Sid93/hemosure-casing/renders/HemoSure_Exploded_20261006T072656Z.png

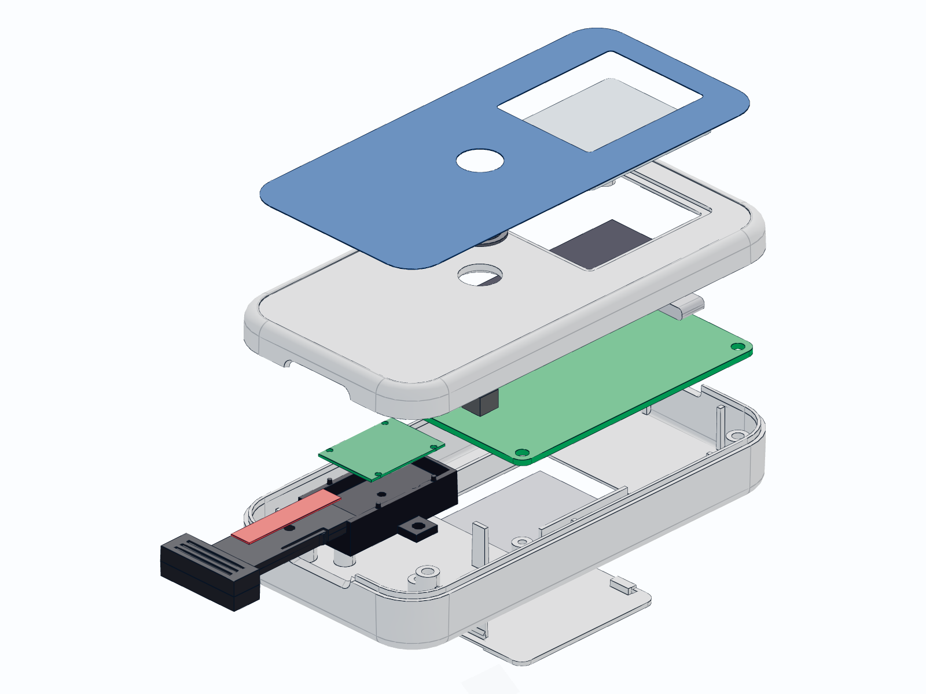
renders/HemoSure_Exploded_20261006T072656Z.png
