Sid93/hemosure-casing/renders/HemoSure_Front_Housing_20260929T104117Z.png

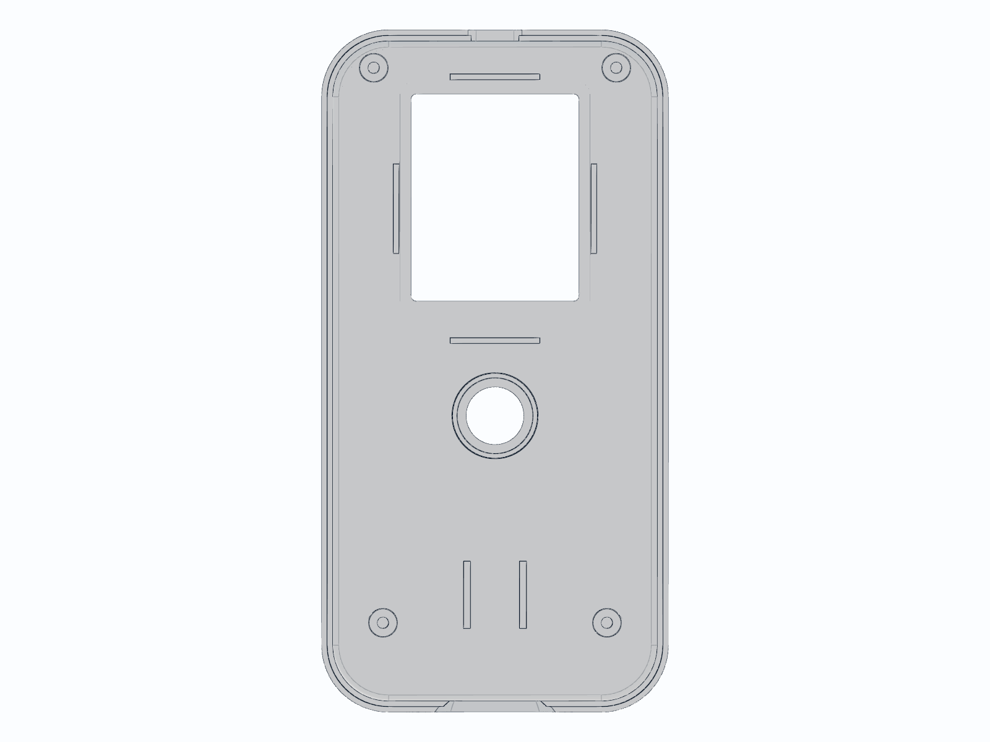
renders/HemoSure_Front_Housing_20260929T104117Z.png
