Sid93/hemosure-casing/renders/HemoSure_Optical_Block_20260929T104113Z.png

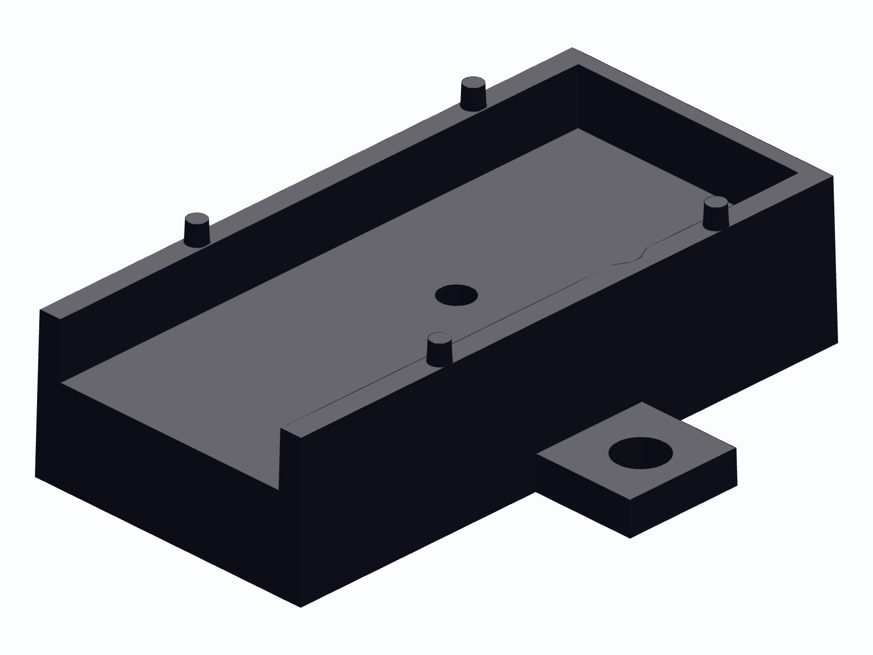
renders/HemoSure_Optical_Block_20260929T104113Z.png
