Sid93/hemosure-casing/renders/HemoSure_Rear_Housing_20260929T104120Z.png

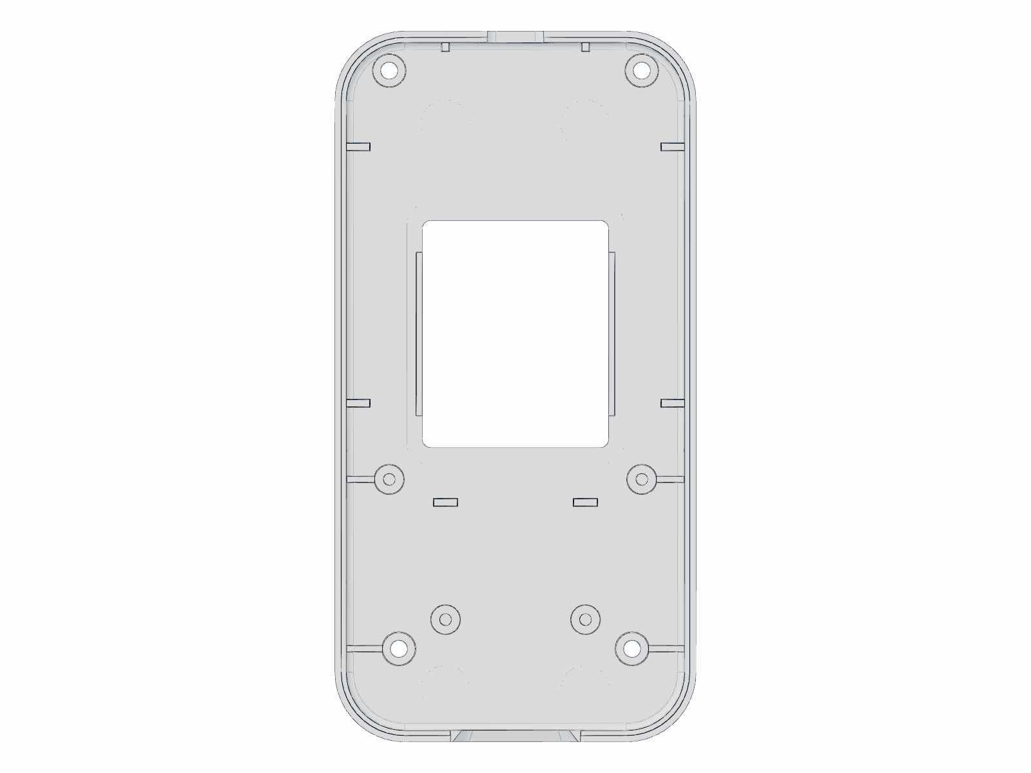
renders/HemoSure_Rear_Housing_20260929T104120Z.png
