Sid93/hemosure-casing/renders/HemoSure_Rear_Housing_CAVITY_20260929T104127Z.png

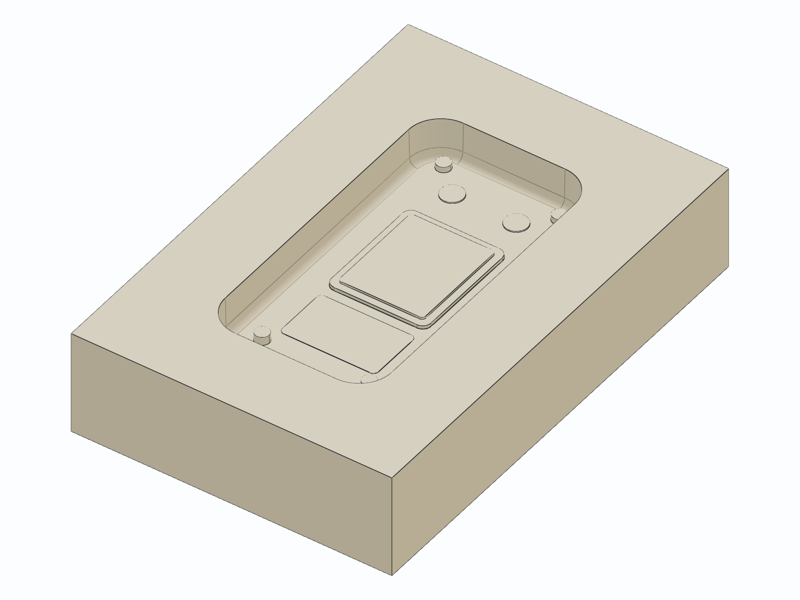
renders/HemoSure_Rear_Housing_CAVITY_20260929T104127Z.png
