Sid93/hemosure-casing/renders/HemoSure_Rear_Housing_CORE_20260929T104123Z.png

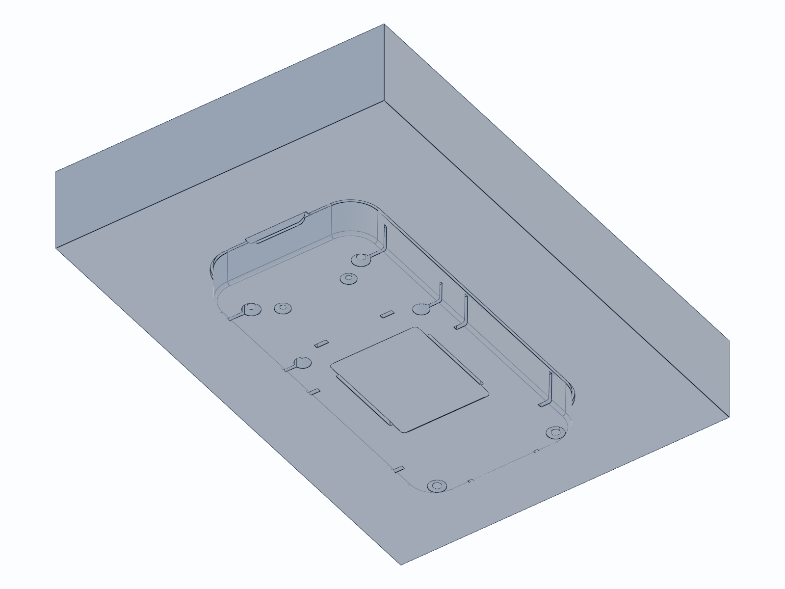
renders/HemoSure_Rear_Housing_CORE_20260929T104123Z.png
