Sid93/hemosure-casing/renders/HemoSure_Strip_Tray_20261006T072645Z.png

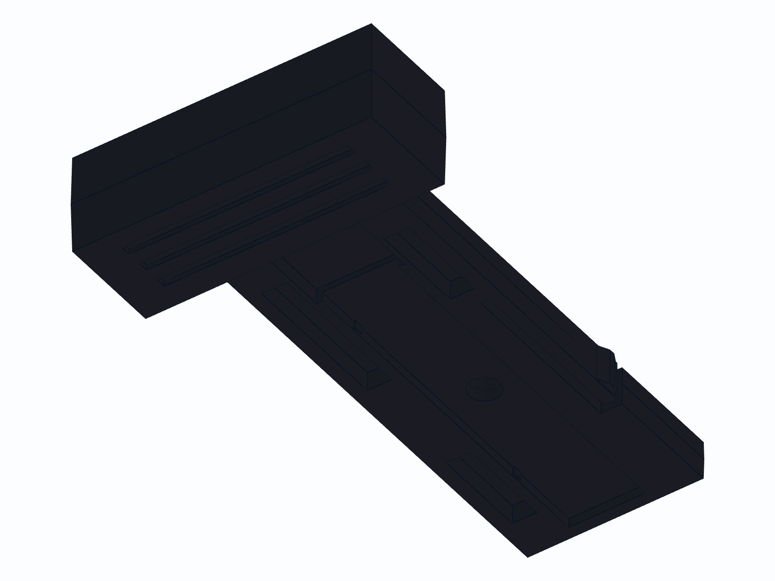
renders/HemoSure_Strip_Tray_20261006T072645Z.png
