Sid93/hemosure-casing/renders/HemoSure_Tray_Open_20261006T072652Z.png

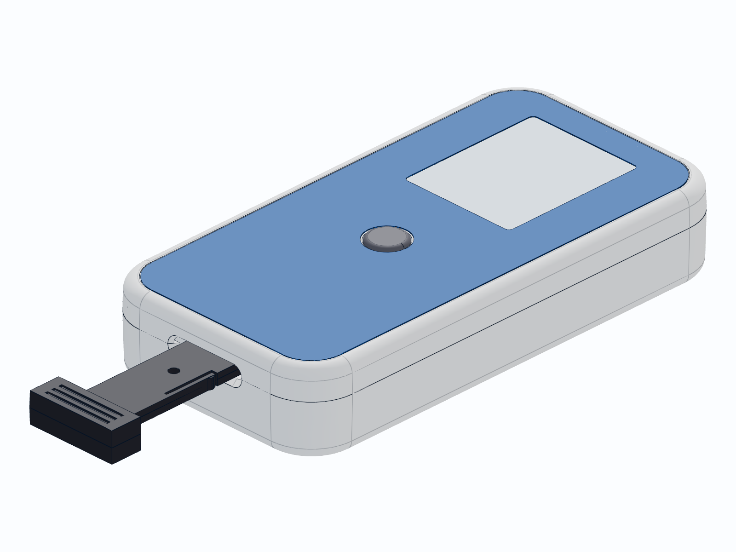
renders/HemoSure_Tray_Open_20261006T072652Z.png
