Sid93/hemosure-casing/cad/HemoSure_Assembly.step

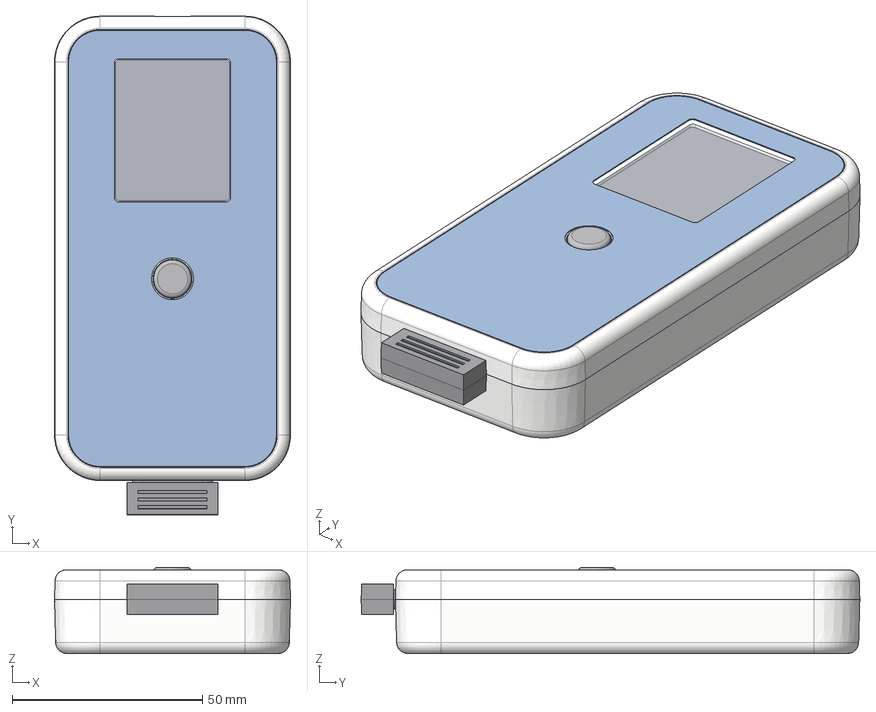
[picture p18: CAD file, 2026-10-06]
cad/HemoSure_Assembly.step
62.0 x 131.0 x 22.6 mm
rear_housing
front_housing
battery_door
button_cap
optical_block_BLACK_ABS
strip_tray_BLACK_ABS
display_lens_PMMA
overlay_PC_printed
REF_pcb_76.75x49.94
REF_tft_1.8in_ST7735
REF_usb_c_receptacle
REF_tact_6x6x5
REF_lipo_503035
REF_hb_strip_6x30x0.5
REF_led_board
