Sid93/hemosure-casing/cad/HemoSure_Exploded.step

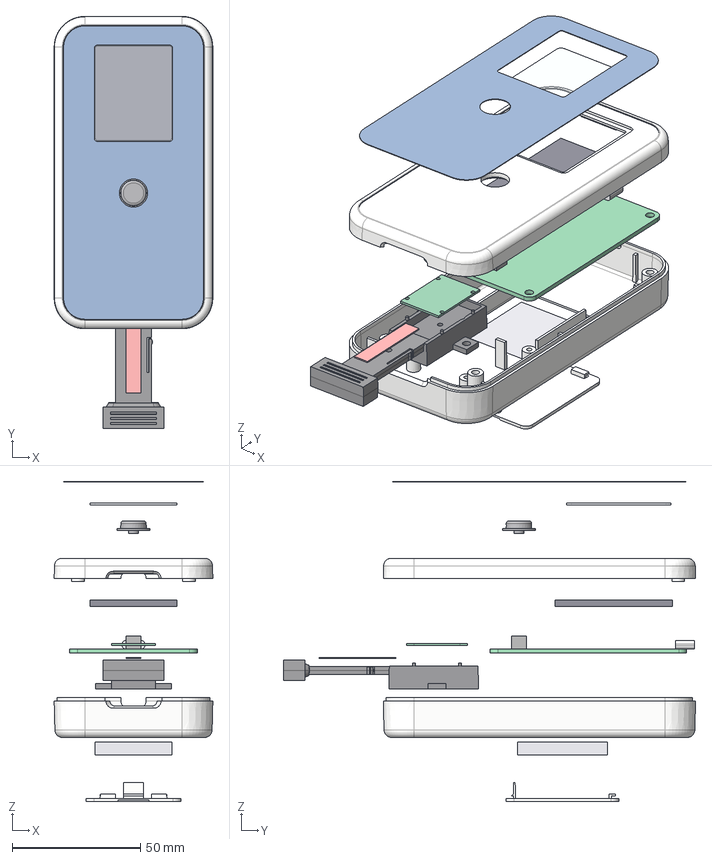
[picture p19: CAD file, 2026-10-06]
cad/HemoSure_Exploded.step
62.0 x 161.0 x 125.0 mm
battery_door
rear_housing
REF_lipo_503035
optical_block_BLACK_ABS
strip_tray_BLACK_ABS
REF_hb_strip_6x30x0.5
REF_led_board
REF_pcb_76.75x49.94
REF_usb_c_receptacle
REF_tact_6x6x5
REF_tft_1.8in_ST7735
front_housing
button_cap
display_lens_PMMA
overlay_PC_printed
