Sid93/hemosure-casing/mold/HemoSure_Strip_Tray_CAVITY.step

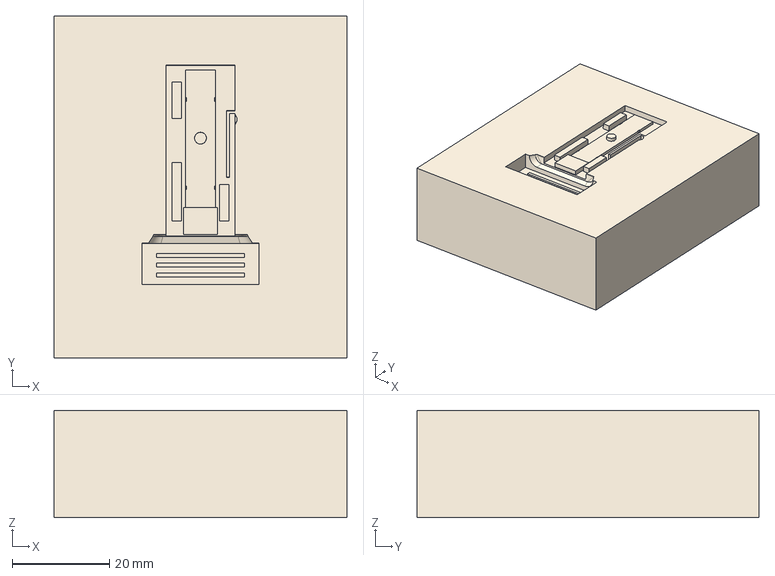
[picture p20: CAD file, 2026-10-06]
mold/HemoSure_Strip_Tray_CAVITY.step
60.3 x 70.3 x 22.1 mm
