Sid93/hemosure-casing/cad/HemoSure_Strip_Tray.step

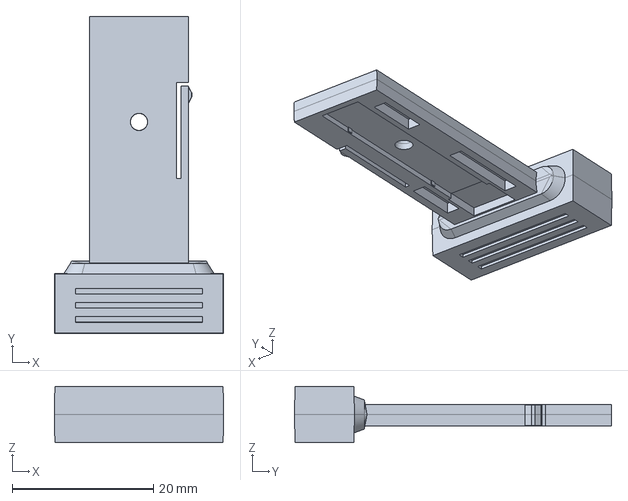
[picture p21: CAD file, 2026-10-06]
cad/HemoSure_Strip_Tray.step
24.0 x 45.0 x 8.00 mm
