Sid93/hemosure-casing/cad/HemoSure_Tray_Open.step

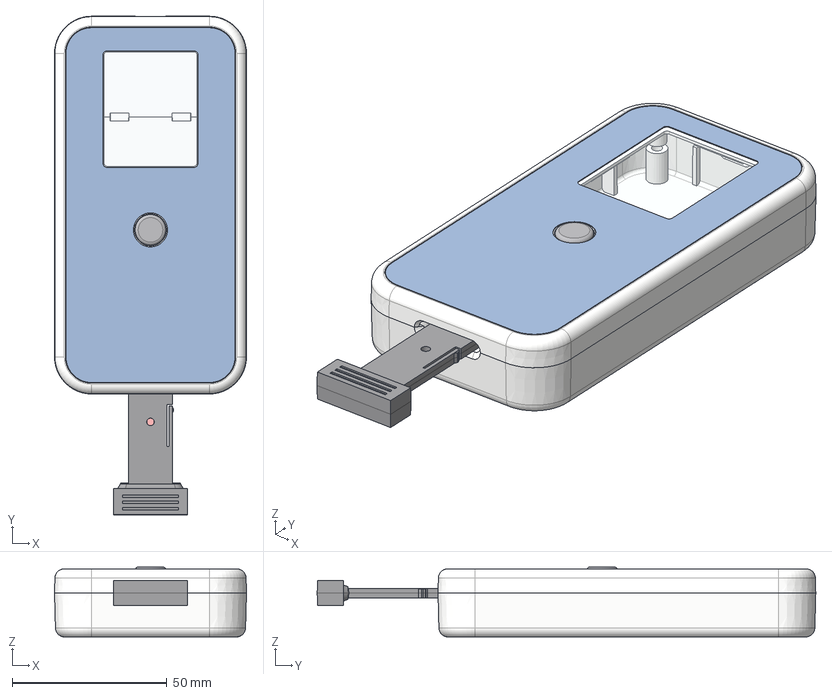
[picture p22: CAD file, 2026-10-06]
cad/HemoSure_Tray_Open.step
62.0 x 161.0 x 22.6 mm
rear_housing
front_housing
button_cap
display_lens_PMMA
overlay_PC_printed
battery_door
strip_tray_BLACK_ABS
REF_hb_strip_6x30x0.5
