Sid93/hemosure-casing/mold/HemoSure_Optical_Block_CORE.step

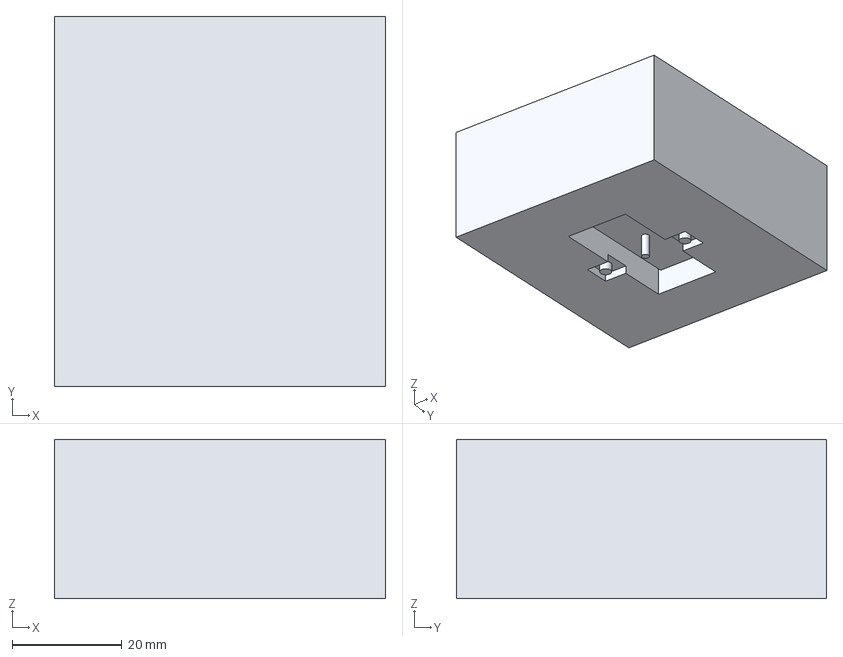
[picture p23: CAD file, 2026-09-29]
mold/HemoSure_Optical_Block_CORE.step
60.3 x 67.3 x 29.0 mm
