Sid93/hemosure-casing/mold/HemoSure_Button_Cap_CAVITY.step

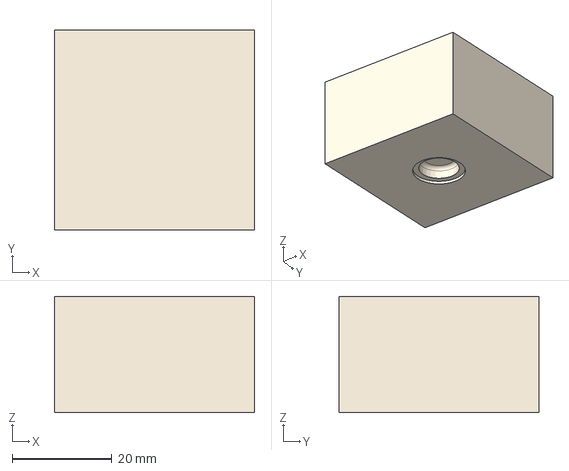
[picture p24: CAD file, 2026-09-29]
mold/HemoSure_Button_Cap_CAVITY.step
40.2 x 40.2 x 23.3 mm
