Sid93/hemosure-casing/stl/HemoSure_Button_Cap_CORE.stl

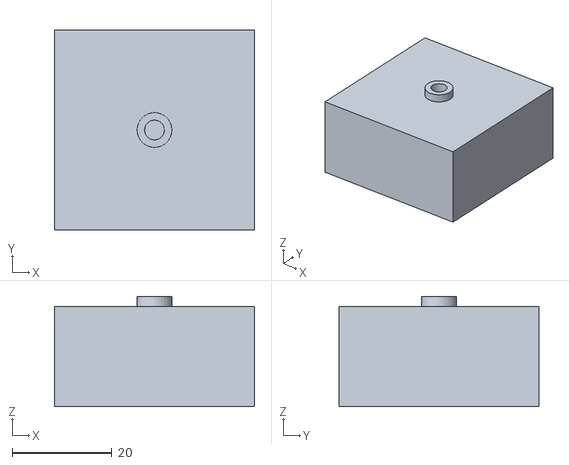
[picture p25: CAD file, 2026-09-28]
stl/HemoSure_Button_Cap_CORE.stl
40.2 x 40.2 x 22.1
