Sid93/hemosure-casing/cad/HemoSure_Battery_Door.step

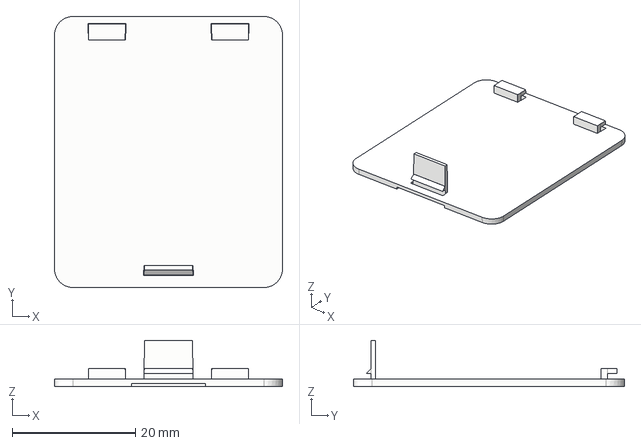
[picture p26: CAD file, 2026-09-29]
cad/HemoSure_Battery_Door.step
37.0 x 44.0 x 7.50 mm
