Sid93/hemosure-casing/mold/HemoSure_Rear_Housing_CAVITY.step

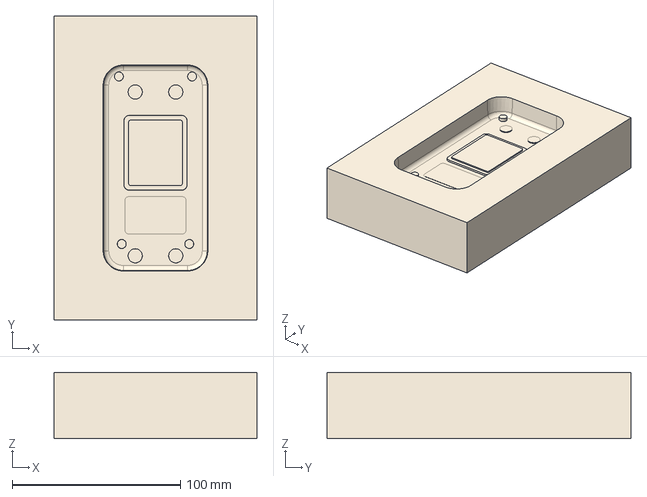
[picture p27: CAD file, 2026-09-29]
mold/HemoSure_Rear_Housing_CAVITY.step
120.6 x 180.9 x 39.4 mm
