Sid93/hemosure-casing/stl/HemoSure_Battery_Door_CAVITY.stl

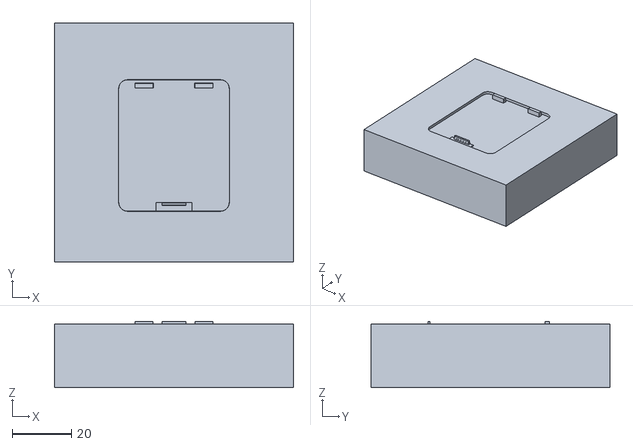
[picture p28: CAD file, 2026-09-28]
stl/HemoSure_Battery_Door_CAVITY.stl
80.4 x 80.4 x 22.2
