Sid93/hemosure-casing/cad/HemoSure_Display_Lens.step

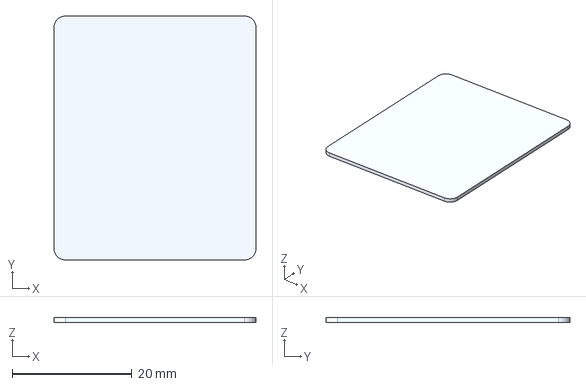
[picture p29: CAD file, 2026-09-29]
cad/HemoSure_Display_Lens.step
33.8 x 40.8 x 0.8 mm
