Sid93/hemosure-casing/cad/HemoSure_Button_Cap.step

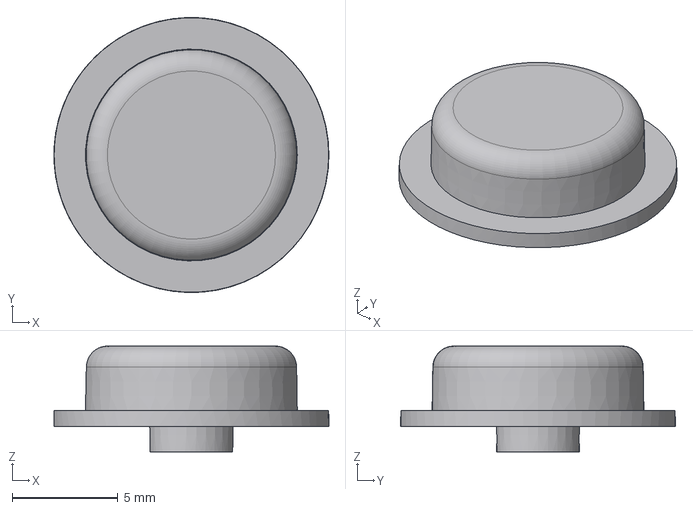
[picture p30: CAD file, 2026-09-29]
cad/HemoSure_Button_Cap.step
13.0 x 13.0 x 5.00 mm
