Sid93/hemosure-casing/stl/HemoSure_Front_Housing_CAVITY.stl

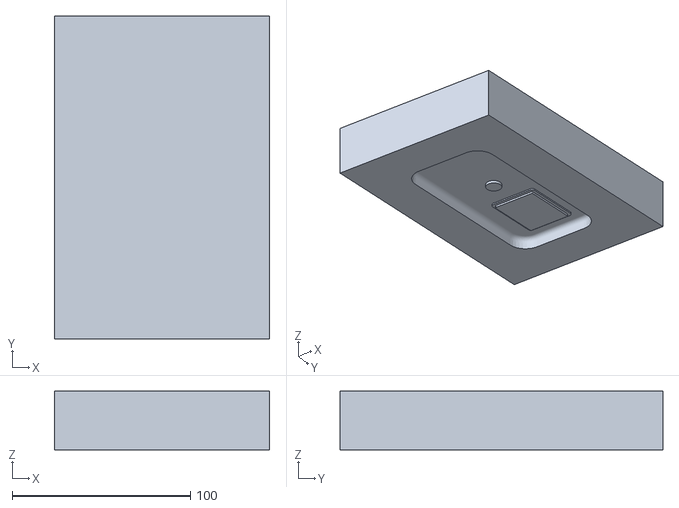
[picture p31: CAD file, 2026-09-28]
stl/HemoSure_Front_Housing_CAVITY.stl
120.6 x 180.9 x 33.0
