Sid93/hemosure-casing/cad/HemoSure_Rear_Housing.step

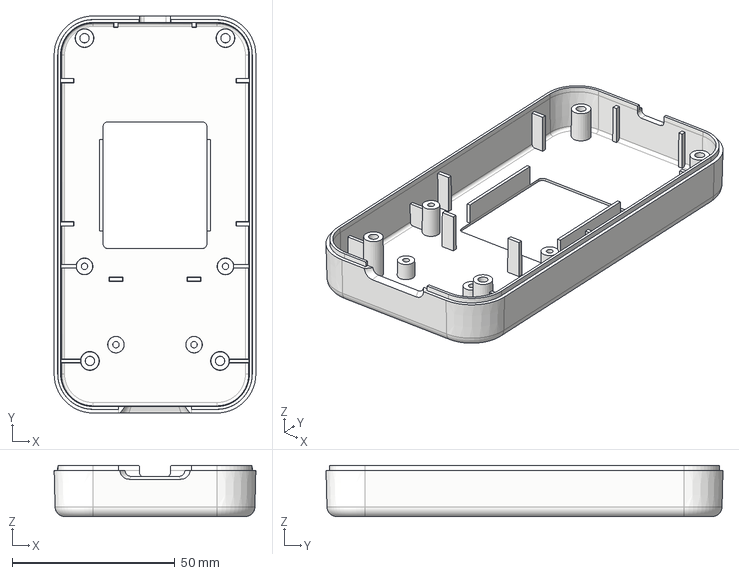
[picture p32: CAD file, 2026-09-29]
cad/HemoSure_Rear_Housing.step
62.0 x 122.0 x 15.7 mm
