Sid93/hemosure-casing/mold/HemoSure_Front_Housing_CORE.step

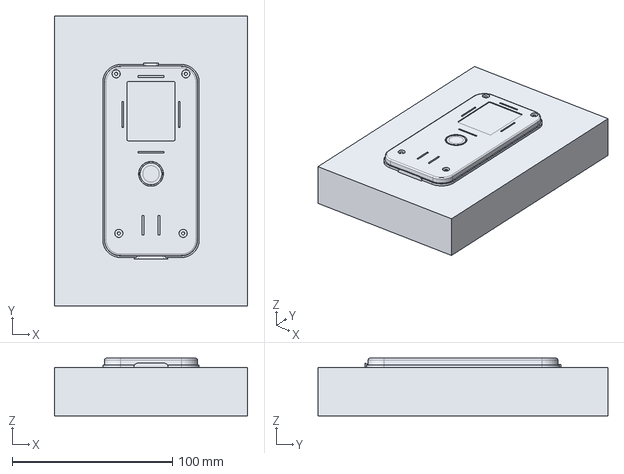
[picture p33: CAD file, 2026-09-29]
mold/HemoSure_Front_Housing_CORE.step
120.6 x 180.9 x 36.0 mm
