Sid93/hemosure-casing/stl/HemoSure_Optical_Block_CAVITY.stl

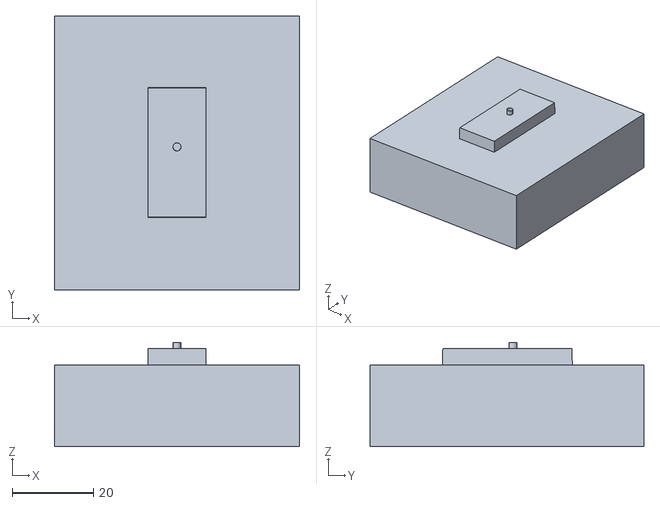
[picture p34: CAD file, 2026-09-28]
stl/HemoSure_Optical_Block_CAVITY.stl
60.3 x 67.3 x 25.7
