Sid93/hemosure-casing/cad/HemoSure_Overlay.step

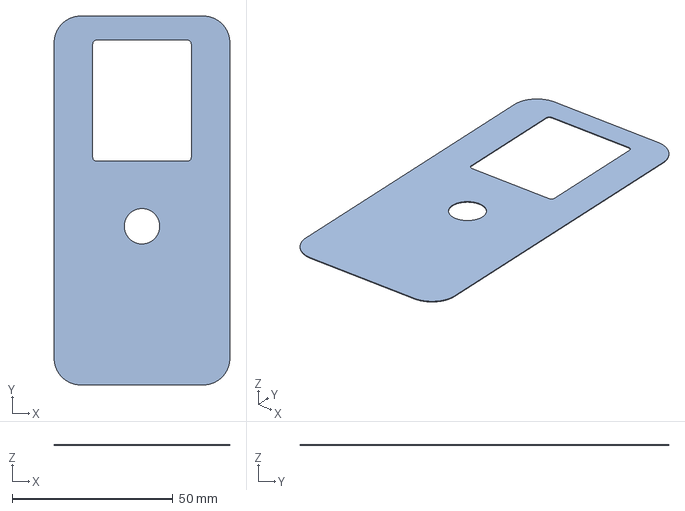
[picture p35: CAD file, 2026-09-29]
cad/HemoSure_Overlay.step
54.6 x 114.6 x 0.225 mm
