Sid93/hemosure-casing/mold/HemoSure_Rear_Housing_CORE.step

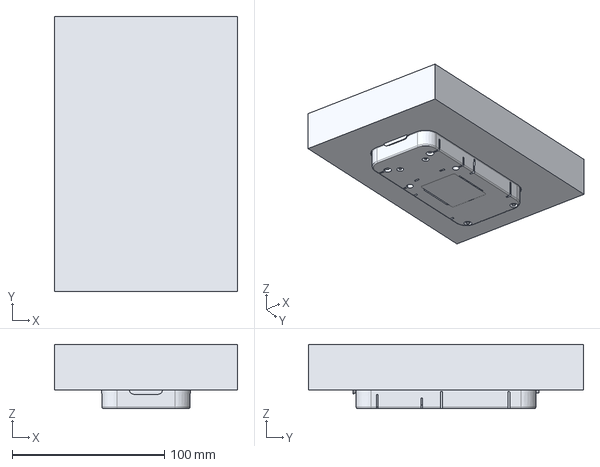
[picture p36: CAD file, 2026-09-29]
mold/HemoSure_Rear_Housing_CORE.step
120.6 x 180.9 x 42.4 mm
