Sid93/hemosure-casing/stl/HemoSure_Battery_Door_CORE.stl

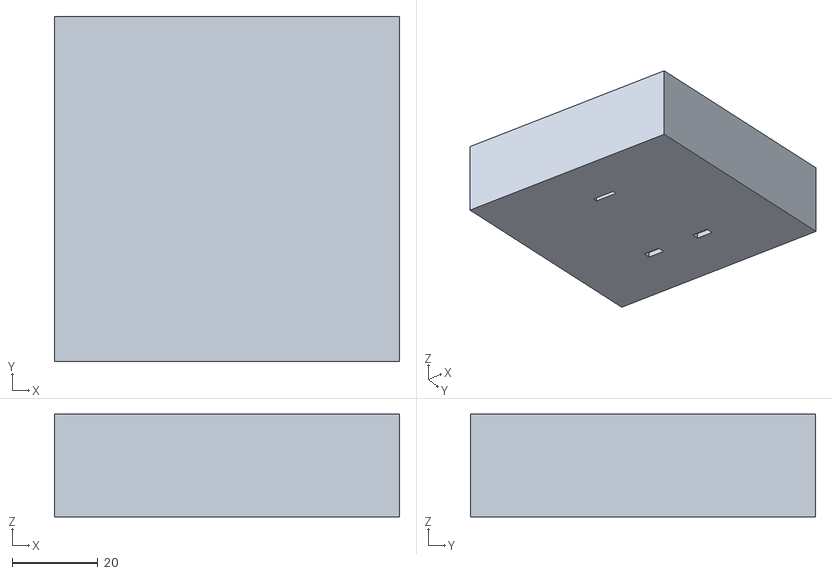
[picture p37: CAD file, 2026-09-28]
stl/HemoSure_Battery_Door_CORE.stl
80.4 x 80.4 x 23.9
