Sid93/hemosure-casing/cad/HemoSure_Optical_Block.step

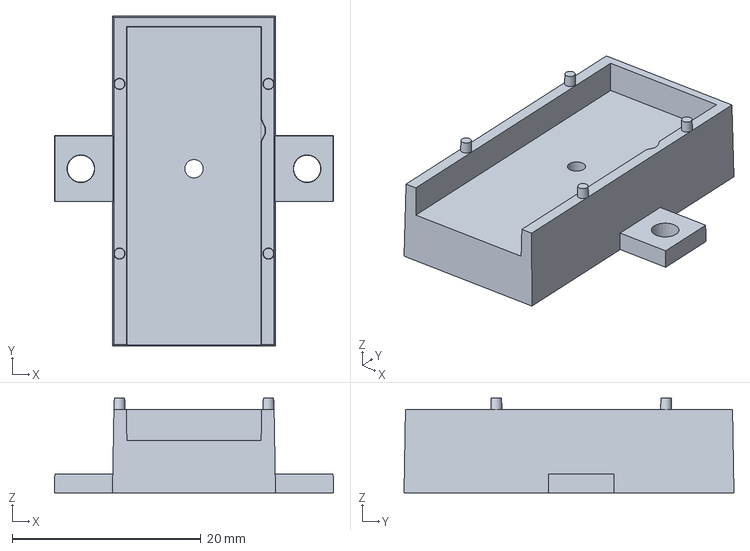
[picture p38: CAD file, 2026-09-29]
cad/HemoSure_Optical_Block.step
29.6 x 35.0 x 10.1 mm
