Sid93/hemosure-casing/cad/HemoSure_Front_Housing.step

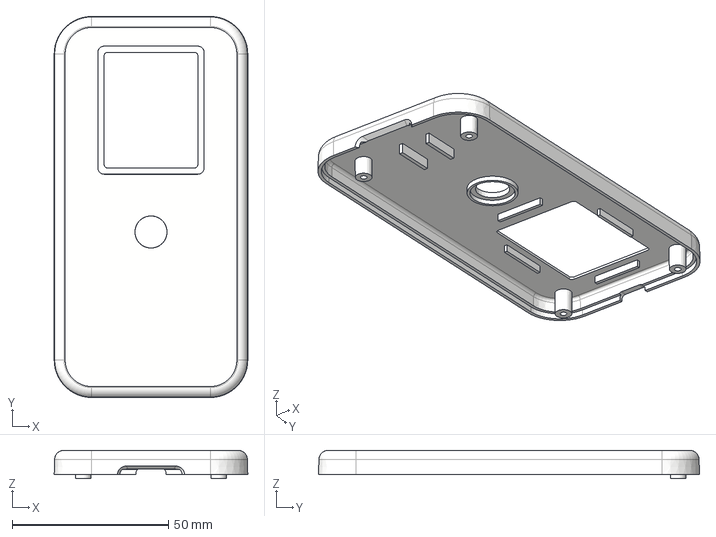
[picture p39: CAD file, 2026-09-29]
cad/HemoSure_Front_Housing.step
62.0 x 122.0 x 9.10 mm
