Sid93/hemosure-casing/(list of files, cad)

Other CAD files:
stl/HemoSure_Strip_Tray_CAVITY.stl
mold/HemoSure_Strip_Tray_CORE.step
stl/HemoSure_Strip_Tray_CORE.stl
stl/HemoSure_Optical_Block_CORE.stl
mold/HemoSure_Battery_Door_CAVITY.step
stl/HemoSure_Button_Cap_CAVITY.stl
mold/HemoSure_Button_Cap_CORE.step
mold/HemoSure_Front_Housing_CAVITY.step
stl/HemoSure_Rear_Housing_CORE.stl
mold/HemoSure_Battery_Door_CORE.step
stl/HemoSure_Front_Housing_CORE.stl
mold/HemoSure_Optical_Block_CAVITY.step
stl/HemoSure_Rear_Housing_CAVITY.stl
stl/HemoSure_Assembly.stl
stl/HemoSure_Battery_Door.stl
stl/HemoSure_Button_Cap.stl
stl/HemoSure_Display_Lens.stl
stl/HemoSure_Exploded.stl
stl/HemoSure_Front_Housing.stl
stl/HemoSure_Optical_Block.stl
stl/HemoSure_Overlay.stl
stl/HemoSure_Rear_Housing.stl
stl/HemoSure_Strip_Tray.stl
stl/HemoSure_Tray_Open.stl
