Sid93/hemosure-casing/renders/HemoSure_Assembly_20261006T072659Z.png

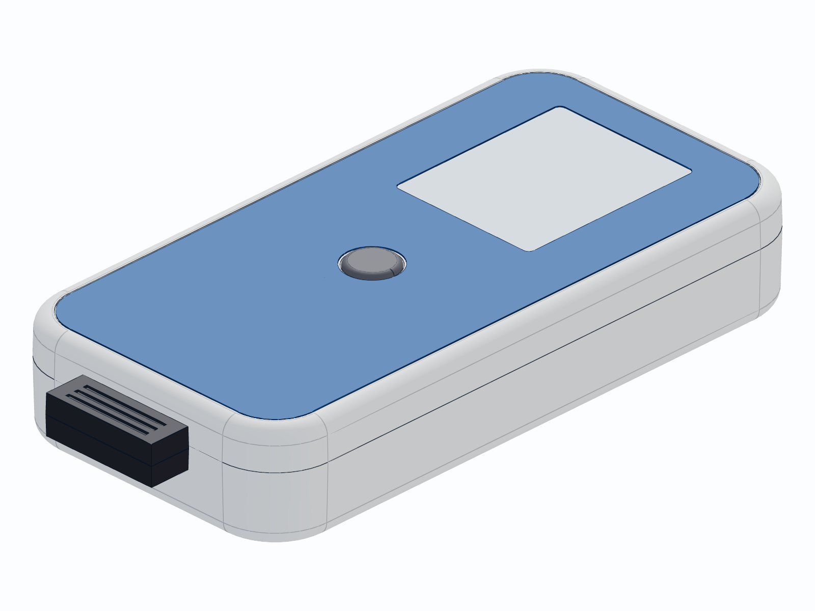
renders/HemoSure_Assembly_20261006T072659Z.png
