Sid93/hemosure-casing/(commit log)

2026-09-28 HemoSure casing Rev A: parts, mould inserts, drawings, STL 3D views
    [HemoSure_Assembly.step, HemoSure_Assembly.stl, HemoSure_Battery_Door.step, HemoSure_Battery_Door.stl, HemoSure_Battery_Door_CAVITY.step, HemoSure_Battery_Door_CAVITY.stl, HemoSure_Battery_Door_CORE.step, HemoSure_Battery_Door_CORE.stl]
2026-09-29 Rev B: slide-in strip tray (HS-106), single-button confirmed, ray-cast mould checks, 22 stack-ups
    [HemoSure_Assembly.step, HemoSure_Assembly.stl, HemoSure_Battery_Door.step, HemoSure_Battery_Door_CAVITY.step, HemoSure_Battery_Door_CORE.step, HemoSure_Button_Cap.step, HemoSure_Button_Cap_CAVITY.step, HemoSure_Button_Cap_CORE.step]
2026-10-06 Rev C: strip pocket on tray underside (read side faces rear), crush-rib retention, 23 stack-ups
    [HemoSure_Assembly.step, HemoSure_Assembly.stl, HemoSure_Exploded.step, HemoSure_Exploded.stl, HemoSure_Strip_Tray.step, HemoSure_Strip_Tray.stl, HemoSure_Strip_Tray_CAVITY.step, HemoSure_Strip_Tray_CAVITY.stl]
